zkeulr/aviator/documents/Design_Document/chapters/overview.tex

\clearpage
\section{System Overview}
\subsection{System Block Diagram}
\begin{figure}[h]
    \centering
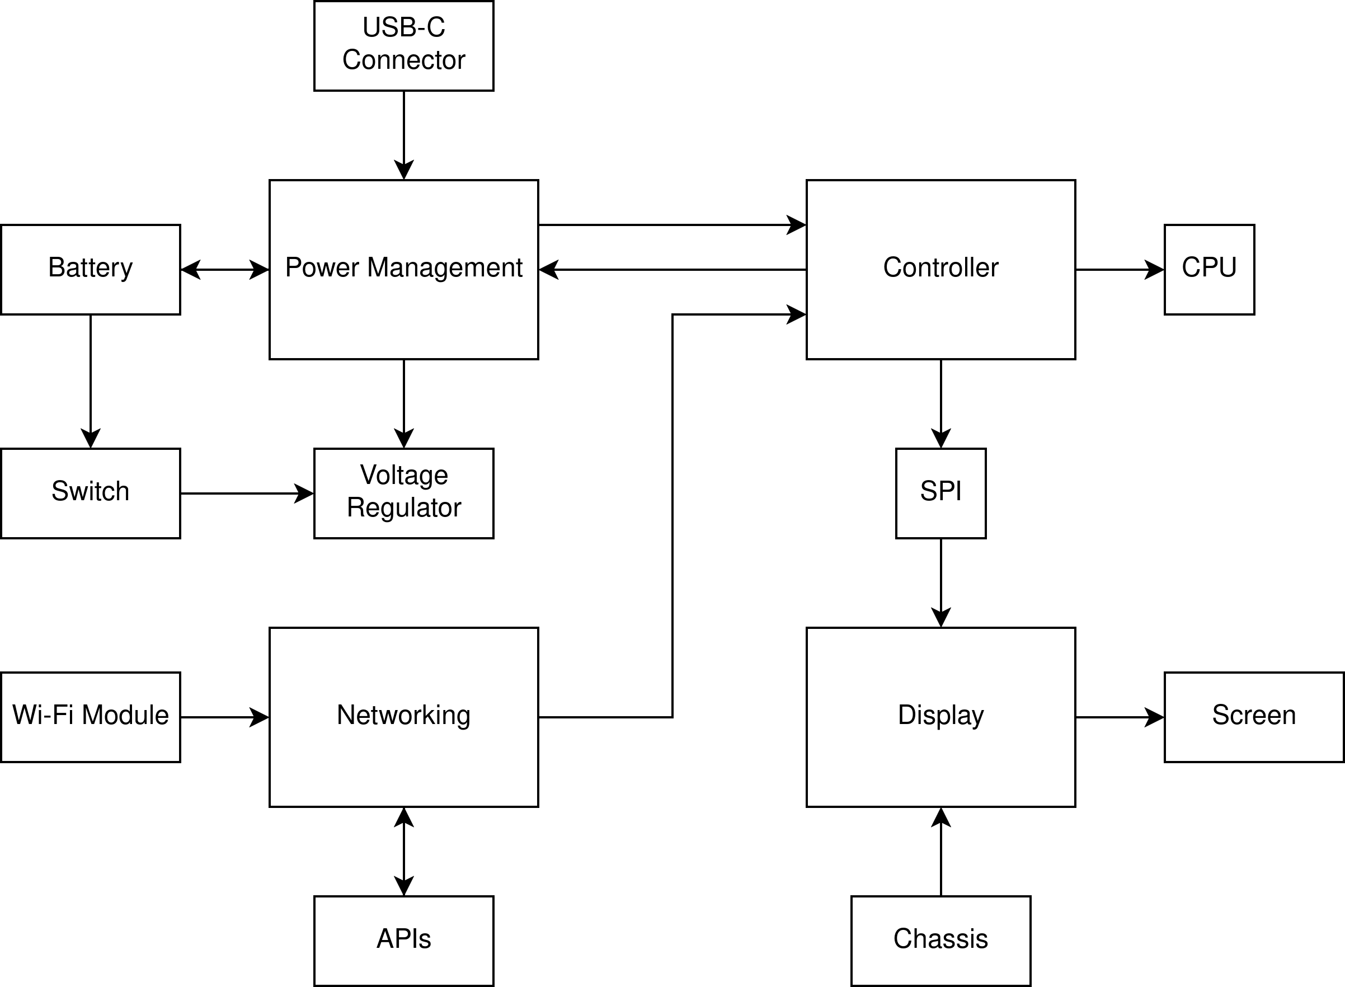
[picture p1: documents/Design_Document_1/images/block_diagram.png]
    
    \caption{Aviator Block Diagram}
\end{figure}

% Activity Diagram
\clearpage
\subsection{System Activity Diagram}
\begin{figure}[h]
    \centering
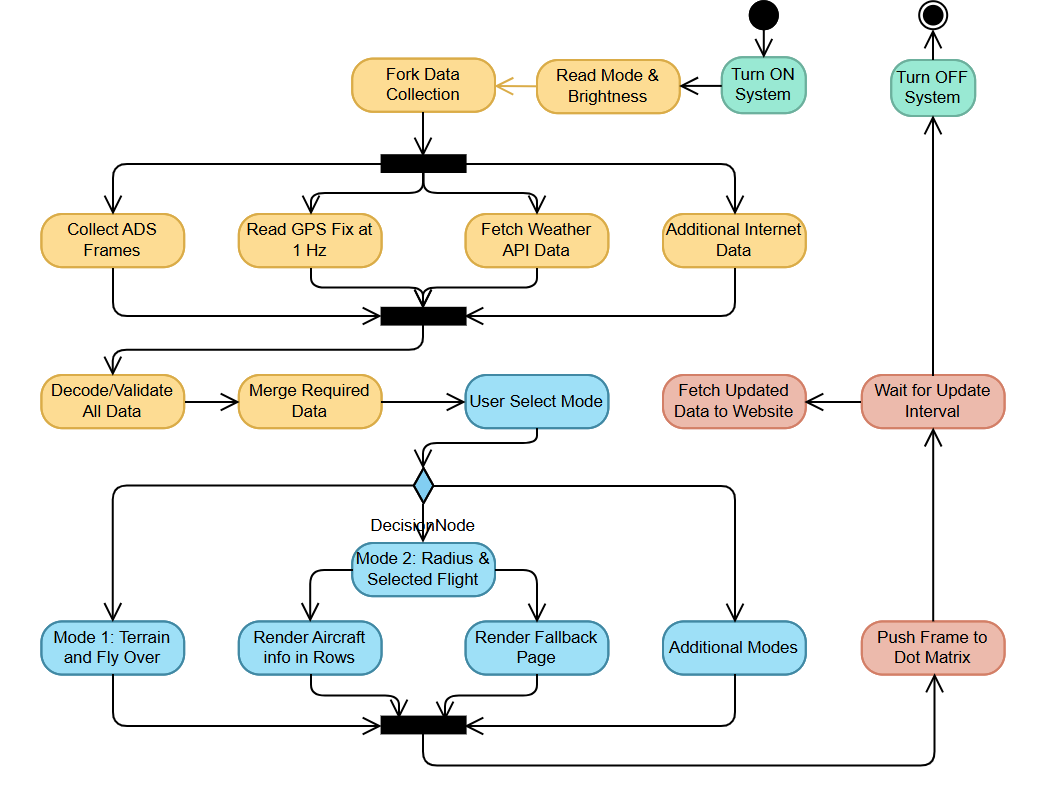
[picture p2: documents/Design_Document_1/images/systemactivitydiagram.png]
     % Change the picture
    \caption{Aviator Activity Diagram}
\end{figure}

% Mechanical Design
\clearpage
\subsection{System Mechanical Design (Extra Credit)}
\begin{figure}[h]
    \centering
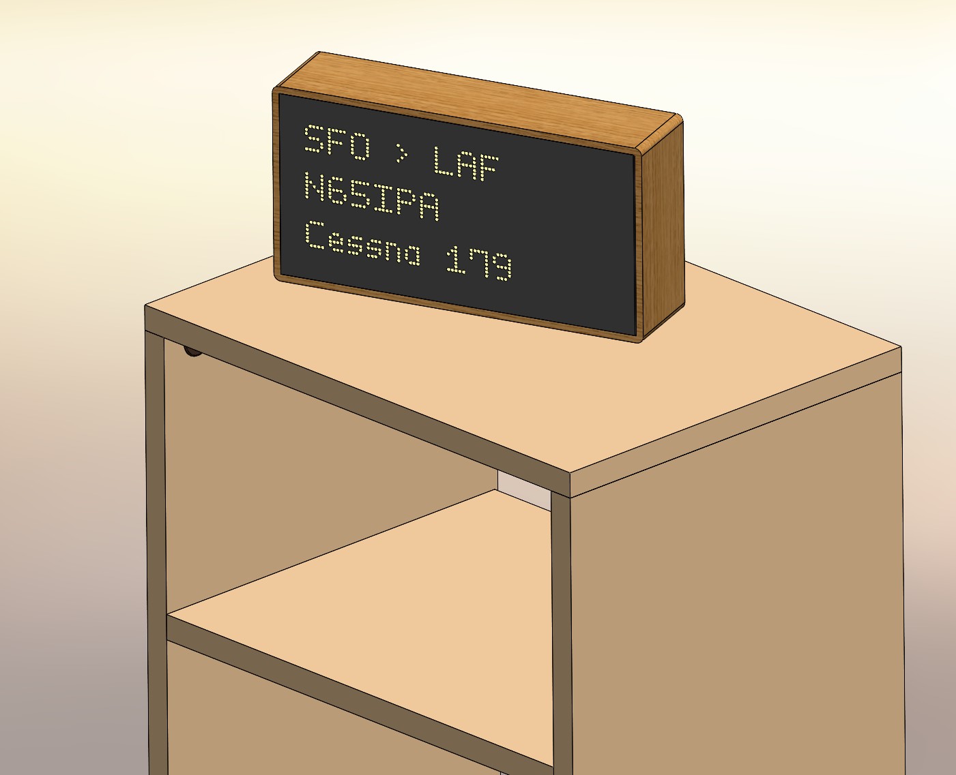
[picture p3: documents/Design_Document/images/CAD/Nightstand Scene.jpg]
     % Change the picture
    \caption{Aviator Enclosure on a generic Nightstand}
\end{figure}

% Integration Approach
\clearpage
\subsection{Integration Approach}
The system integrates an ADS-B software-defined radio (SDR), a cloud data pool,
a local processing subsystem, a display module, and a power management
subsystem. The ADS-B SDR publishes raw flight data to the cloud pool;
the processing subsystem ingests that cloud stream plus external APIs
and user inputs, normalizes and filters the data, and forwards compact
display updates to the display module. The power management subsystem
supplies energy to the processor and display and includes a battery
backup to preserve state and reduce startup latency.

Design priorities are resilience and graceful degradation: if network
connectivity is lost the device continues to show local time and the last
cached flight/weather state; if power to the device is interrupted the
ADS-B transmitter can still upload to the cloud independently. Data is
cached locally and keyed by timestamp so that, on reconnection, the
processor can quickly reconcile and display missed updates. Interfaces
are defined around simple, versioned JSON payloads and REST/WebSocket
endpoints to minimize coupling and simplify testing. Latency, cache
expiration, and failure modes are documented per interface to guide
integration testing.

% System Photograph
\clearpage
\subsection{System Photographs} % Have as many photoes as you need
\begin{figure}[h]
    \centering
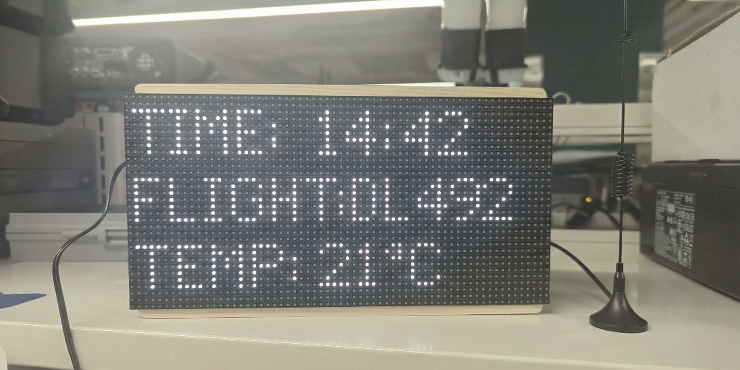
[picture p4: documents/Design_Document/images/ExamplePhoto.jpg]
     % Change the picture
    \caption{Photograph of assembled system}
\end{figure}
\begin{figure}[h]
    \centering
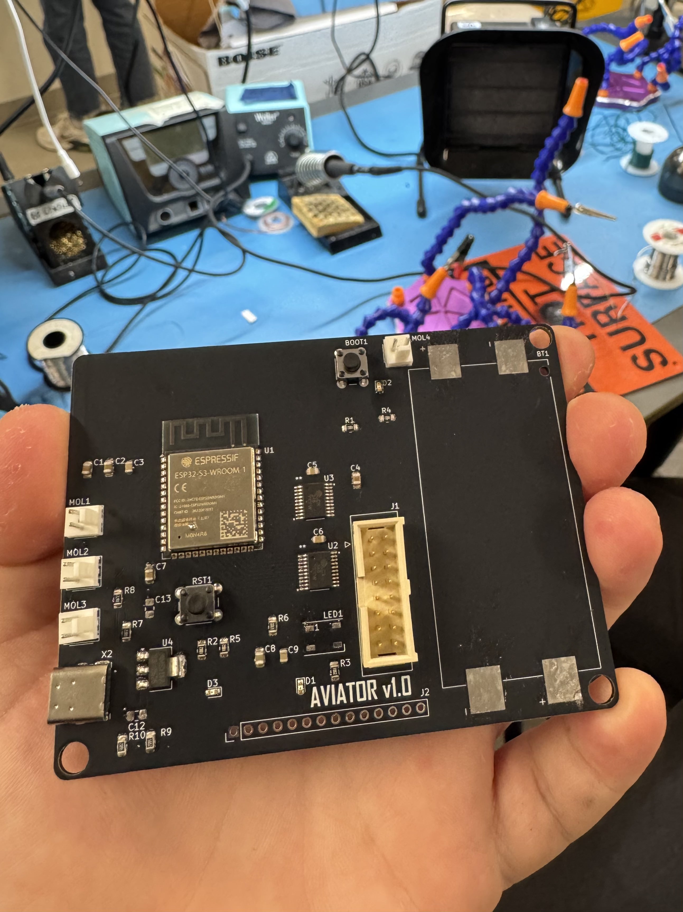
[picture p5: documents/Design_Document/images/PCB/AssembledPCB.jpg]
     % Change the picture
    \caption{Photograph of assembled PCB}
\end{figure}
