zkeulr/aviator/documents/Design_Document/chapters/pcb.tex

\clearpage
\section{PCB Design}
\subsection{PCB Schematics}
\begin{figure}[!h]
    \centering
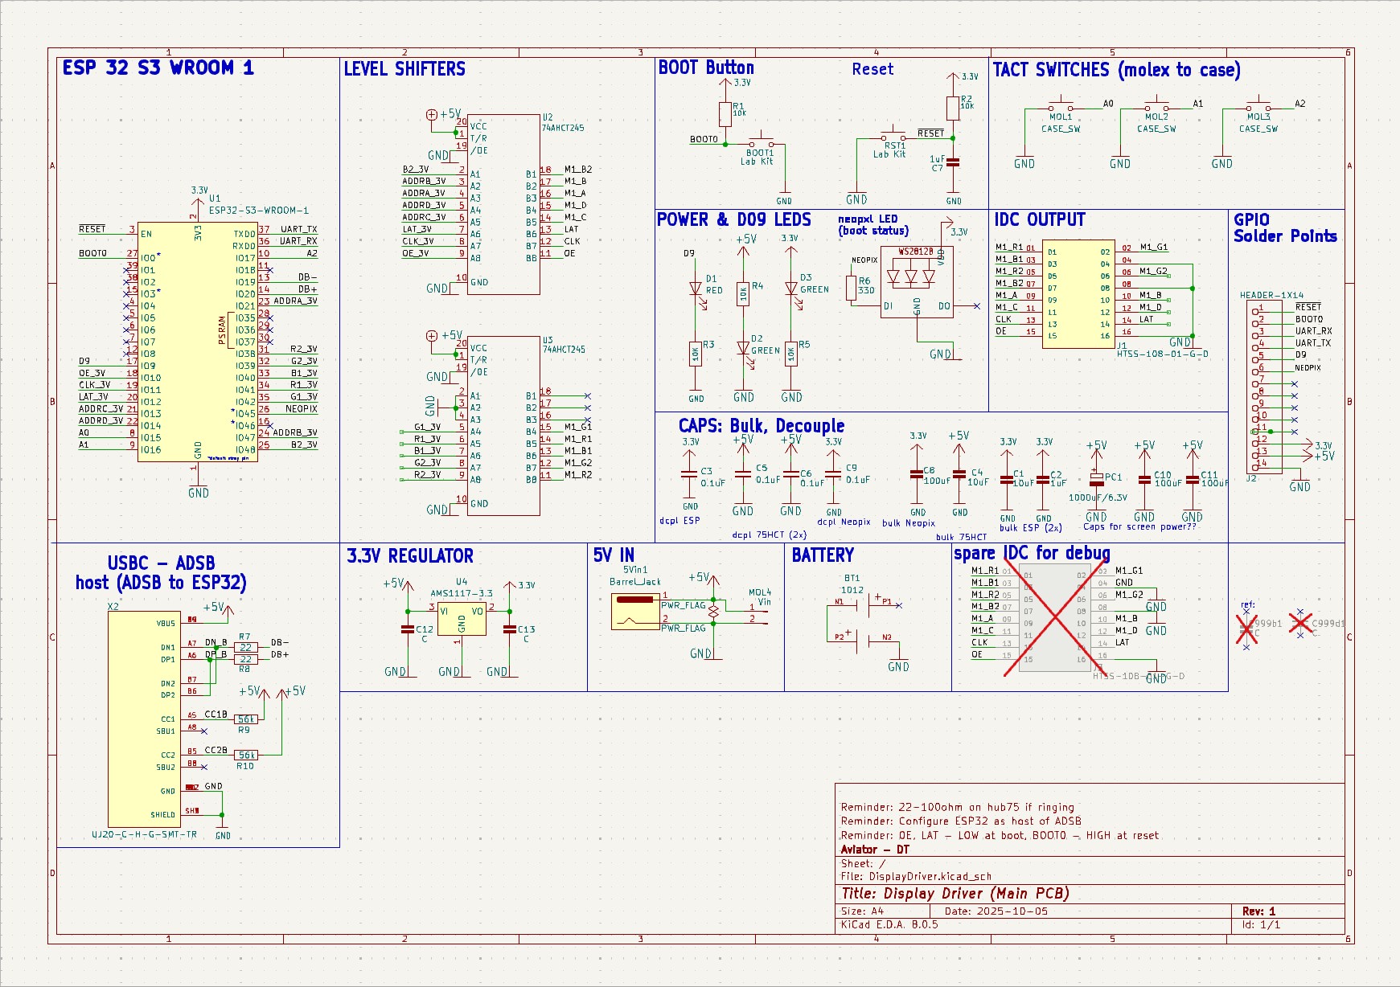
[picture p6: documents/Design_Document/images/PCB/PCB_Schematic.jpg]
     % Change the picture
    \caption{PCB Schematic}
\end{figure}

\clearpage
\subsection{PCB Layout}
\begin{figure}[h]
    \centering
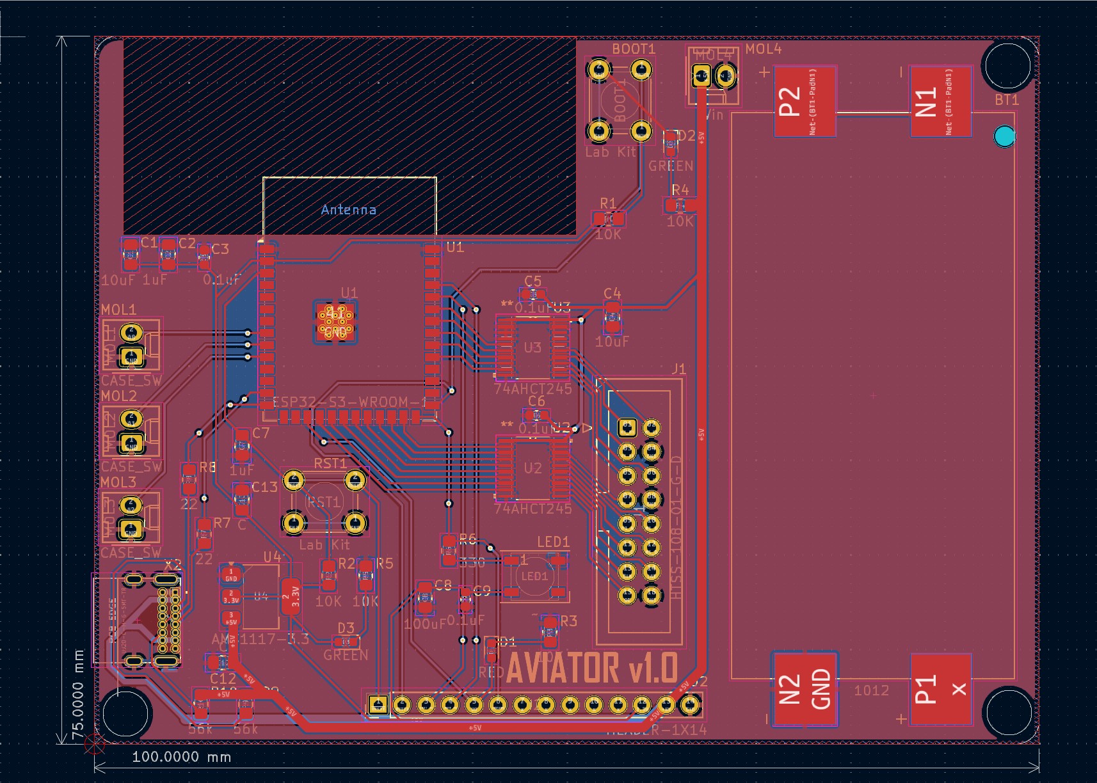
[picture p7: documents/Design_Document/images/PCB/PCB_WithCuPlanes.jpg]
     % Change the picture
    \caption{PCB Layout}
\end{figure}
\begin{figure}[h]
    \centering
     % Change the picture
    \caption{PCB CAD Layout}
\end{figure}
