zkeulr/aviator/documents/Design_Document/chapters/subsystems/display.tex

\subsection{Subsystem 3: Text Display}
% Subsystem Diagram
\subsubsection{Subsystem Diagrams}
\begin{figure}[h]
    \centering
     % Change the picture
    \caption{Display subsystem Block Diagram}
\end{figure} % If your subsystem is more coding, change it to activity diagram

% Specifications
\subsubsection{Specifications}
\begin{enumerate}
    \item Feature a 2048-pixel Dot Display (64 x 32px)
    \item Physical dimensions of housing within 5\% of 64 x 128 x 256 mm.
    \item No noticable screen tear (refresh rate > 60Hz)
\end{enumerate}

% Subsystem Interactions
\subsubsection{Subsystem Interactions}
The display subsystem links the main PCB and the LED Matrix. This subsystem will interface all subsystems on and the main PCB. It will recieve data from the network and communiations subsystem, from the main PCB and processing subsytem it will recieve commands regarding the format of the display, interpret the commands, and display the relevant air traffic data.

% Core ECE
\subsubsection{Core ECE Design Tasks}
\begin{itemize}
    \item \textbf{ECE 27000}: Provides a solid foundation in logic circuits. Helps for designing registers, data paths, logic that drives the LED panel.
    \item \textbf{ECE 25500}: Provides a base understanding of transisters, amplifiers, and fundamentals into I-V behavior.
    \item \textbf{ECE 40862}: Teaches valuable STM concepts such as programming, interrupts, and DMA which are needed to drive the display controller efficiently.
\end{itemize}

% Schematics
\subsubsection{Schematics}

\begin{figure}[H]
    \centering
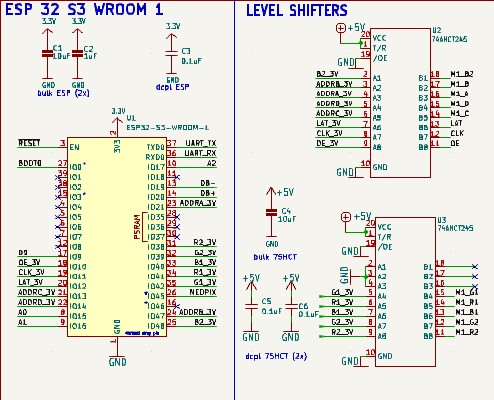
[picture p16: documents/Design_Document/images/DisplayDriver/dispDriverSchematic.jpg]
    
    \caption{Display Driver Schematic (1/2)}
\end{figure}

\begin{figure}[H]
    \centering
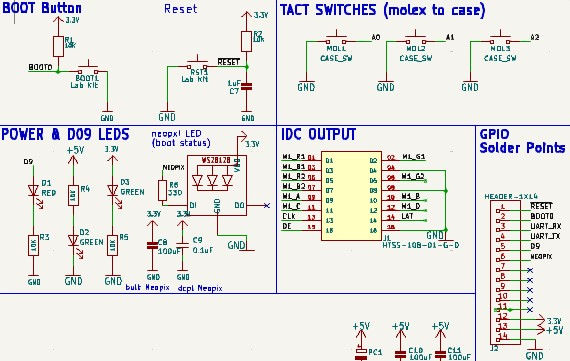
[picture p17: documents/Design_Document/images/DisplayDriver/dispDriverSchematic2.jpg]
    
    \caption{Display Driver Schematic (2/2) and features}
\end{figure}

\FloatBarrier

% Parts List
\subsubsection{Parts}
\begin{itemize}
    \item LED Matrix (ADAFruit, 32x64, P4)
    \begin{itemize}
        \item 02x08 Pin header (IDC Connection)
    \end{itemize}
    \item Resistors:
    \begin{itemize}
        \item 330
        \item 10k (5)
    \end{itemize}
    \item Capacitors
    \begin{itemize}
        \item 0.1uF (0603) (3)
        \item 1uF (0805)
        \item 10uF (0805)
        \item 100uF (0805)
    \end{itemize}
    \item Diodes 
    \begin{itemize}
        \item Red (0603) 
        \item Green (0603) (2)
    \end{itemize}
    \item Switches and Buttons
    \begin{itemize}
        \item 01x02 Molex (Case Switch) (3)
        \item 6mm THM Push Button (2)
    \end{itemize}
\end{itemize}

% Algorithm
\subsubsection{Algorithm}

\begin{lstlisting}
    Initialize:
    Configure GPIOs (DATA, CLK, LAT, OE, row select lines (A,B,C,D))
    Initialize interface for incoming data
    Initialize timer for refresh interrupts
    Set PWM resolution (e.g., 8-bit)

    Main Loop:
    while (true):
        if new frame data available from main PCB:
            copy frame buffer into local memory (double buffer optional)
        
        for each row_index in 0 .. NUM_ROWS-1:
            select_row(row_index)        
            OE = HIGH                   
            
            for pwm_bit = 7 downto 0:    // for 8-bit PWM
                for col_index = 0 .. NUM_COLS-1:
                    pixel = frame_buffer[row_index][col_index]
                    if pixel.red  & (1 << pwm_bit) != 0:
                        DATA_R = HIGH
                    else:
                        DATA_R = LOW
                    if pixel.green & (1 << pwm_bit) != 0:
                        DATA_G = HIGH
                    else:
                        DATA_G = LOW
                    if pixel.blue & (1 << pwm_bit) != 0:
                        DATA_B = HIGH
                    else:
                        DATA_B = LOW
                    
                    pulse(CLK)           
                    
                pulse(LAT)                
                OE = LOW                   
                delay(PWM_DELAY[pwm_bit])  
                
        repeat indefinitely
\end{lstlisting}

% Theory of Operation
\subsubsection{Theory of Operation}
\paragraph{}
The Display subsystem serves as the primary interface between the ESP32-S3-WROOM-1 microcontroller and a HUB75d 32×64 RGB LED matrix, enabling real-time visualization of aviation and weather data. 
The ESP32 handles pixel generation, frame buffering, and timing control for row and column scanning of the display. 
Core signals — including LAT (latch), OE (output enable), CLK (clock), and address lines A–E — are driven directly from the ESP32’s GPIO pins and level-shifted from 3.3 V logic to the 5 V domain required by the HUB75 interface. 
The RGB data lines (R1, G1, B1, R2, G2, B2) are similarly translated to ensure proper color channel switching for both the upper and lower halves of the LED matrix. 
\paragraph{}
During operation, the ESP32 continuously cycles through the address lines, updating one row at a time while controlling brightness through pulse-width modulation synchronized with the OE signal. 
Power is supplied through regulated 5 V and 3.3 V rails, supporting both the LED panel and logic circuitry. 
Optional pushbuttons provide manual reset and boot functionality, while status LEDs indicate system power and data activity. 
In system deployment, the display subsystem retrieves aircraft position and weather telemetry from networked sources and ADS-B data, translating this incoming data into text output or images. 
This modular design allows the subsystem to function independently or as an integrated component of the larger Aviator platform, focusing on robustness, timing precision, and electrical isolation between logic and display domains.

% Specification Measurement
\subsubsection{Specifications Measurement}
\begin{enumerate}
    \item Feature a 2048-pixel Dot Display (64 x 32px)
    \item   The correct screen was ordered, featuring a 32x64px RGB LED matrix
    \item Physical dimensions of housing within 5\% of 64 x 128 x 256 mm.
    \item   Measured with ruler and calipers, the actual screen dimensions are 127 x 255 mm.
    \item No noticable screen tear (refresh rate > 60Hz)
    \item   In observing the screen during normal operation, the image is clear and constant with no noticable tear. Achieved >60Hz refresh rate
          
\end{enumerate}

% Standards
\subsubsection{Standards}
\begin{itemize}
    \item \textbf{IEC 61010}: Safety for low-voltage electronic equipment; ensures protection against shorts, overcurrent, and handling risks.
    \item \textbf{SPI/I²C}: If MCU/controller communicates with peripheral ICs over standard buses.
    \item \textbf{HUB75}: Standard for 32×64 RGB LED matrices; timing, row multiplexing, and data latching must be followed.
    \item \textbf{JESD51}: Important for high-current LED arrays; ensures heat dissipation and junction temperatures are within safe limits.
\end{itemize}
