zkeulr/aviator/aviator/emoji/README.txt

╔═════════════════════════════════════════════════════════════════════════════╗
║                    ~~~ SerenityOS RGI emoji set ~~~                         ║
╟─────────────────────────────────────────────────────────────────────────────╢
║                                                                             ║
║ → This archive was created: 2025-12-07 23:59:01                             
║                                                                             ║
║ → Downloaded from: https://emoji.serenityos.net/                            
║                                                                             ║
║ → Source: https://github.com/SerenityOS/serenity/tree/master/Base/res/emoji 
║                                                                             ║
║ → Only Unicode RGI(recommended for general interchange) emoji               
║   included in this set                                                      
║                                                                             ║
║ → License: BSD 2-Clause License                                             
║                                                                             ║
║ ⌂ LICENSE.txt - Complete license for these emoji                            
║                                                                             ║
║ ⌂ LIST_OF_EMOJI.txt - All emoji, glyphs and names included in this set      
║                                                                             ║
╚═════════════════════════════════════════════════════════════════════════════╝
