zkeulr/aviator/documents/Design_Document/Design_Document.tex

\documentclass[letterpaper, 11pt]{article}
\usepackage{cite,enumitem,listings, comment}
\usepackage[export]{adjustbox}
\usepackage{amsmath,amssymb,amsfonts}
\usepackage{algorithmic}
\usepackage{graphicx}
\usepackage{textcomp}
\usepackage{graphicx}
\usepackage{geometry}
\usepackage{tabularx}
\usepackage{xcolor}
\usepackage{soul}
\usepackage{chngcntr}
\usepackage{url}
\usepackage{hyperref}
\usepackage{graphicx}
\usepackage{float}
\usepackage{placeins}
\usepackage{caption}
\usepackage{graphicx}
\counterwithin{figure}{subsection}

\begin{document}

%%%%%%%%%%%%%%%% Document Starts %%%%%%%%%%%%%%%%%%%%%

% Title page 
\title{Aviator Design Document}
\author{David Thoe, Joshua Kim, Zeke Ulrich, Juan Vargas}
\date{\today}
\maketitle

\begin{center}
    GTA: Ruihang Ni \\
    Professor: Minghao Qi
\end{center}

% Sketch goes here
\begin{figure}[h]
    \centering
    
    \caption{Sketch}
\end{figure}

\clearpage
\tableofcontents

\clearpage
\listoffigures

\clearpage
\listoftables

% Revision Log Page
\clearpage
\section{Revision Log}
% For every update, copy a whole LATEX code line and adjust 
% accordingly. In theory, update every time you make major 
% changes in the document. The \& symbol serves to separate 
% items in the table. If you are new to this, align the \& 
% so that it looks more like a table in the code. 
\begin{table}[h]
    \centering
    \begin{tabularx}{\textwidth}{|l|c|X|c|}
        \hline
        Date       & Revision & Changes              & Initials \\ \hline
        05/03/2024 & v0.1     & Initial Release      & ZU       \\ \hline
        09/18/2025 & v0.2     & First Submission     & ZU       \\ \hline
        10/05/2025 & v0.3     & Second Submission    & DT       \\ \hline
        11/11/2025 & v0.4     & Corrections, Updates & DT       \\ \hline
        12/13/2025 & v1.0     & Final Release        & ZU       \\ \hline
    \end{tabularx}
    \caption{Revision Log}
\end{table}

% Glossary Page
\clearpage
\section{Glossary} % Document key words and acronyms here. 
\begin{itemize}
    \item \textbf{API} Application Programming Interface.
    \item \textbf{ADS-B} Automatic Dependent Surveillance-Broadcast
\end{itemize}

\include{chapters/intro}
\include{chapters/requirements}
\include{chapters/overview}
\section{Subsystems}
\include{chapters/subsystems/processing}
\include{chapters/subsystems/power}
\include{chapters/subsystems/display}
\include{chapters/subsystems/network}
\include{chapters/pcb}
\include{chapters/status}
\include{chapters/team_structure}

\end{document}
