zkeulr/aviator/documents/Design_Document/Design_Document_1.tex

\documentclass[letterpaper, 11pt]{article}
\usepackage{cite,enumitem,listings, comment}
\usepackage[export]{adjustbox}
\usepackage{amsmath,amssymb,amsfonts}
\usepackage{algorithmic}
\usepackage{graphicx}
\usepackage{textcomp}
\usepackage{graphicx}
\usepackage{geometry}
\usepackage{tabularx}
\usepackage{xcolor}
\usepackage{soul}
\usepackage{chngcntr}
\usepackage{url}
\usepackage{hyperref}
\counterwithin{figure}{subsection}

\begin{document}

%%%%%%%%%%%%%%%% Document Starts %%%%%%%%%%%%%%%%%%%%%

% Title page 
\title{Aviator Design Document}
\author{David Thoe, Joshua Kim, Zeke Ulrich, Juan Vargas}
\date{\today}
\maketitle

\begin{center}
    GTA: Zixiao Ma \\
    Professor: Ryan Beasley
\end{center}

% Sketch goes here
\begin{figure}[h]
    \centering
    
    \caption{[Caption]}
\end{figure}

\clearpage
\tableofcontents

\clearpage
\listoffigures

\clearpage
\listoftables

% Revision Log Page
\clearpage
\section*{Revision Log}
% For every update, copy a whole LATEX code line and adjust 
% accordingly. In theory, update every time you make major 
% changes in the document. The \& symbol serves to separate 
% items in the table. If you are new to this, align the \& 
% so that it looks more like a table in the code. 
\begin{table}[h]
    \begin{tabularx}{\textwidth}{|l|c|X|} % 
        \hline
        Date      & Revision & Changes         \\ \hline
        5/3/2024  & v0.1     & Initial Release \\ \hline
        9/18/2025 & v1.0     & First Draft     \\ \hline
    \end{tabularx}
    \caption{Revision Log}
\end{table}

% Glossary Page
\clearpage
\section*{Glossary} % Document key words and acronyms here. 
\begin{itemize}
    \item \textbf{API} Application Programming Interface.
\end{itemize}

\include{chapters/intro}
\include{chapters/requirements}
\include{chapters/overview}
\section{Subsystems}
\include{chapters/subsystems/processing}
\include{chapters/subsystems/power}
\include{chapters/subsystems/display}
\include{chapters/subsystems/network}
\include{chapters/pcb}
\include{chapters/status}
\include{chapters/team_structure}

%%%%%%%%%%%%%%%%% Biblography %%%%%%%%%%%%%%%%%%%%%%%
\clearpage
\section{Bibliography}

 [Here are some examples. IEEE format can be found on \href{https://owl.purdue.edu/owl/research_and_citation/ieee_style/ieee_overview.html}{\hl{Purdue OWL}}. ]

\begin{thebibliography}{}

    \bibitem{b1}
    “Data Platform - Open Power System data,” Apr. 15, 2020. https://data.open-power-system-data.org/household\_data/

    \bibitem{b2}
    Author,"Title," \emph{Journal},volume,number, page range, month year, DOI.

    \bibitem{b3}
    Author. "Page."Website. URL(accessed month day,year)

\end{thebibliography}

%%%%%%%%%%%%%%%%% Appendix %%%%%%%%%%%%%%%%%%%%%%%%%
\clearpage
\section{Appendices}
 [This section is mainly designed for code. You can directly generate a somewhat decent display of your code file or psuedo code by using the template provided below. You can have as many appendix as you want. In the document, you can refer to the code posted here instead of pasting the whole code in the body. ]

\end{document}
