zkeulr/aviator/documents/Design_Document/images/DisplayDriver/DisplayDriver Schematic.jpg

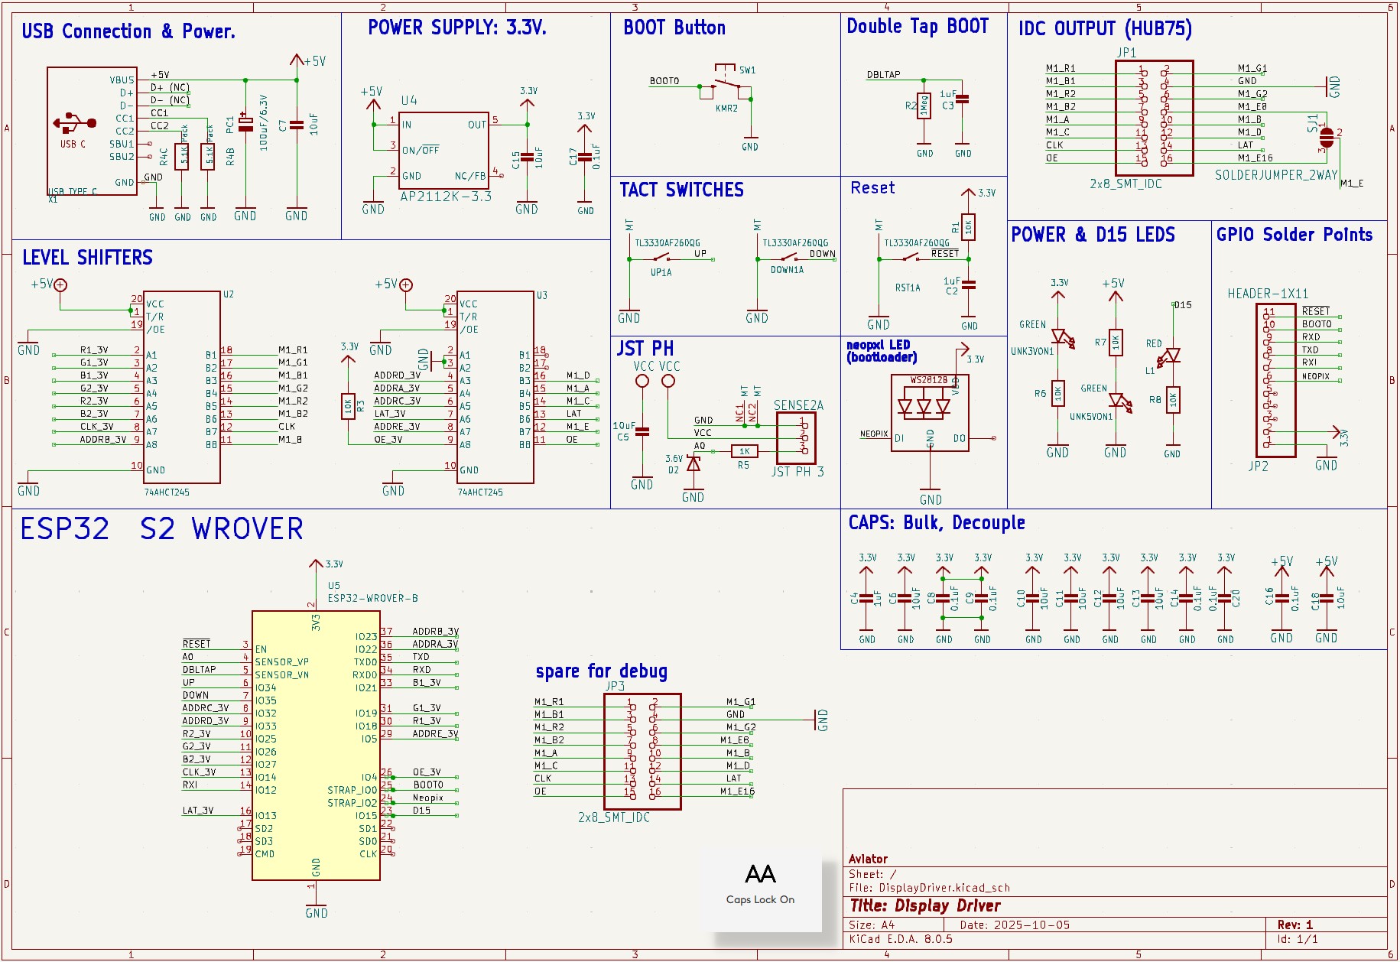
documents/Design_Document/images/DisplayDriver/DisplayDriver Schematic.jpg
