zkeulr/aviator/documents/Design_Document/images/DisplayDriver/DriverBoardFeatures.jpg

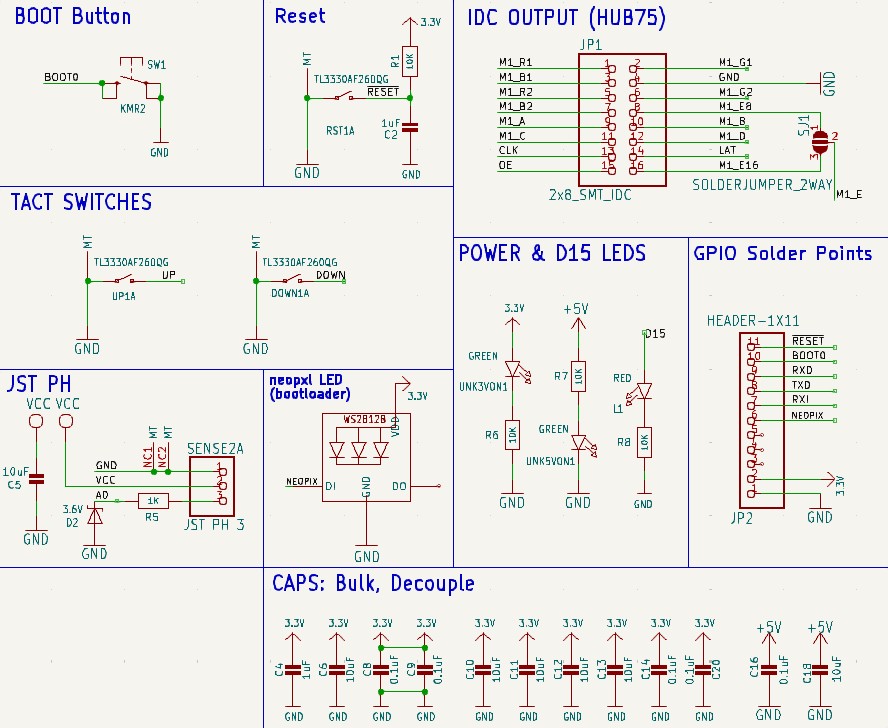
documents/Design_Document/images/DisplayDriver/DriverBoardFeatures.jpg
