zkeulr/aviator/documents/Design_Document/images/DisplayDriver/USBPwrGeneric.jpg

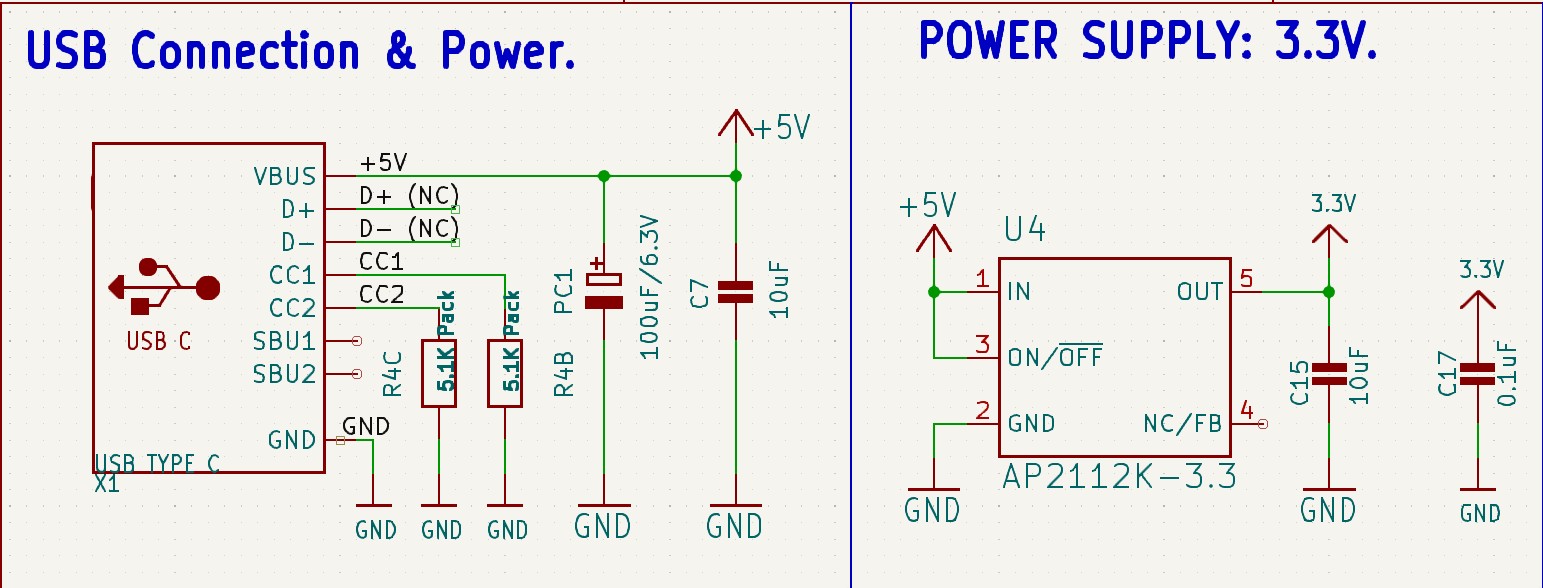
documents/Design_Document/images/DisplayDriver/USBPwrGeneric.jpg
