zkeulr/aviator/documents/Design_Document/images/juan.jpg

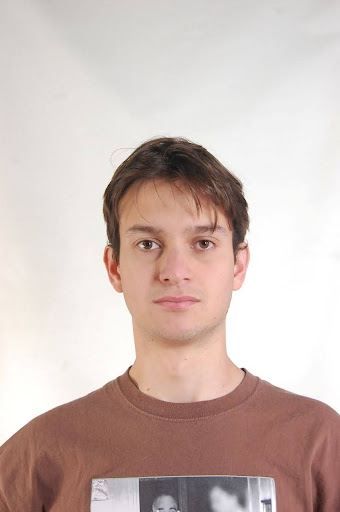
documents/Design_Document/images/juan.jpg
