zkeulr/aviator/documents/Design_Document/images/tempSF.jpg

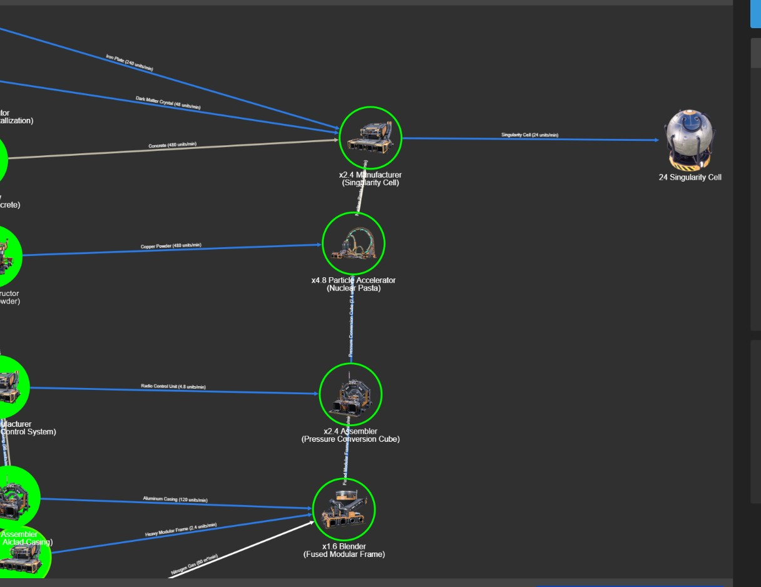
documents/Design_Document/images/tempSF.jpg
