zkeulr/aviator/DisplayDriver/PCBMaterials.csv

Reference | Value | Datasheet | Footprint | Qty | DNP
5Vin1 | Barrel_Jack | ~ |  | 1 | x
BOOT1,RST1 | Lab Kit | ~ | Button_Switch_THT:SW_PUSH_6mm | 2 | x |  | !
BT1 | 1012 |  | DisplayLibrary:BAT_1012 | 1 | x |  | !
C1,C4 | 10uF |  | Capacitor_SMD:C_0805_2012Metric_Pad1.18x1.45mm_HandSolder | 2 | x | ECE SHOP
C2,C7 | 1uF |  | Capacitor_SMD:C_0805_2012Metric_Pad1.18x1.45mm_HandSolder | 2 | x | ECE SHOP
C3,C5,C6,C9 | 0.1uF | ~ | Capacitor_SMD:C_0603_1608Metric | 4 | x | ECE SHOP
C8,C10,C11 | 100uF |  | Capacitor_SMD:C_0805_2012Metric_Pad1.18x1.45mm_HandSolder | 3 | x | ECE SHOP
C12,C12B1,C13,C13B1 | C | -- mixed values -- | -- mixed values -- | 4 | x | TBD
D1 | RED | ~ | LED_SMD:LED_0603_1608Metric | 1 | x | ECE SHOP
D2,D3 | GREEN | ~ | LED_SMD:LED_0603_1608Metric | 2 | x | ECE SHOP
J1 | HTSS-108-01-G-D |  | DisplayDriver:IDC-Header_2x08_P2.54mm_Vertical | 1 | x
J2 | HEADER-1X14 | ~ | Connector_PinHeader_2.54mm:PinHeader_1x14_P2.54mm_Vertical | 1
LED1 | ~ | ~ | LED_SMD:LED_WS2812B_PLCC4_5.0x5.0mm_P3.2mm | 1
MOL1,MOL2,MOL3 | CASE_SW | ~ | Connector_Molex:Molex_KK-254_AE-6410-02A_1x02_P2.54mm_Vertical | 3
MOL4 | Vin | ~ | Connector_Molex:Molex_KK-254_AE-6410-02A_1x02_P2.54mm_Vertical | 1
PC1 | 1000uF/6.3V |  | Capacitor_SMD:C_0805_2012Metric_Pad1.18x1.45mm_HandSolder | 1 | x | ECE SHOP
R1,R2,R3,R4,R5 | 10K | ~ | Resistor_SMD:R_0805_2012Metric_Pad1.20x1.40mm_HandSolder | 5 | x | ECE SHOP
R6 | 330 | ~ | Resistor_SMD:R_0805_2012Metric_Pad1.20x1.40mm_HandSolder | 1 | x | ECE SHOP
R7,R8 | 22 | ~ | Resistor_SMD:R_0805_2012Metric_Pad1.20x1.40mm_HandSolder | 2 | x | ECE SHOP
R9,R10 | 56k | ~ | Resistor_SMD:R_0805_2012Metric_Pad1.20x1.40mm_HandSolder | 2 | x | ECE SHOP
U1 | ESP32-S3-WROOM-1 | https://www.espressif.com/sites/default/files/documentation/esp32-s3-wroom-1_wroom-1u_datasheet_en.pdf | RF_Module:ESP32-S3-WROOM-1 | 1
U2,U3 | 74AHCT245 | https://www.ti.com/lit/ds/symlink/sn74lvch245a.pdf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 | DisplayDriver:PW20 | 2
U4 | AMS1117-3.3 | http://www.advanced-monolithic.com/pdf/ds1117.pdf | Package_TO_SOT_SMD:SOT-223-3_TabPin2 | 1
U5 | AP2112K-3.3 | https://www.diodes.com/assets/Datasheets/AP2112.pdf | Package_TO_SOT_SMD:SOT-23-5 | 1 | x | EXTRA
X2 | UJ20-C-H-G-SMT-TR | https://www.snapeda.com/parts/UJ20-C-H-G-SMT-TR/Same%20Sky/datasheet/ | DisplayDriver:CUI_UJ20-C-H-G-SMT-TR | 1
