zkeulr/aviator/documents/Design_Document/images/DisplayDriver/WroverUsage.jpg

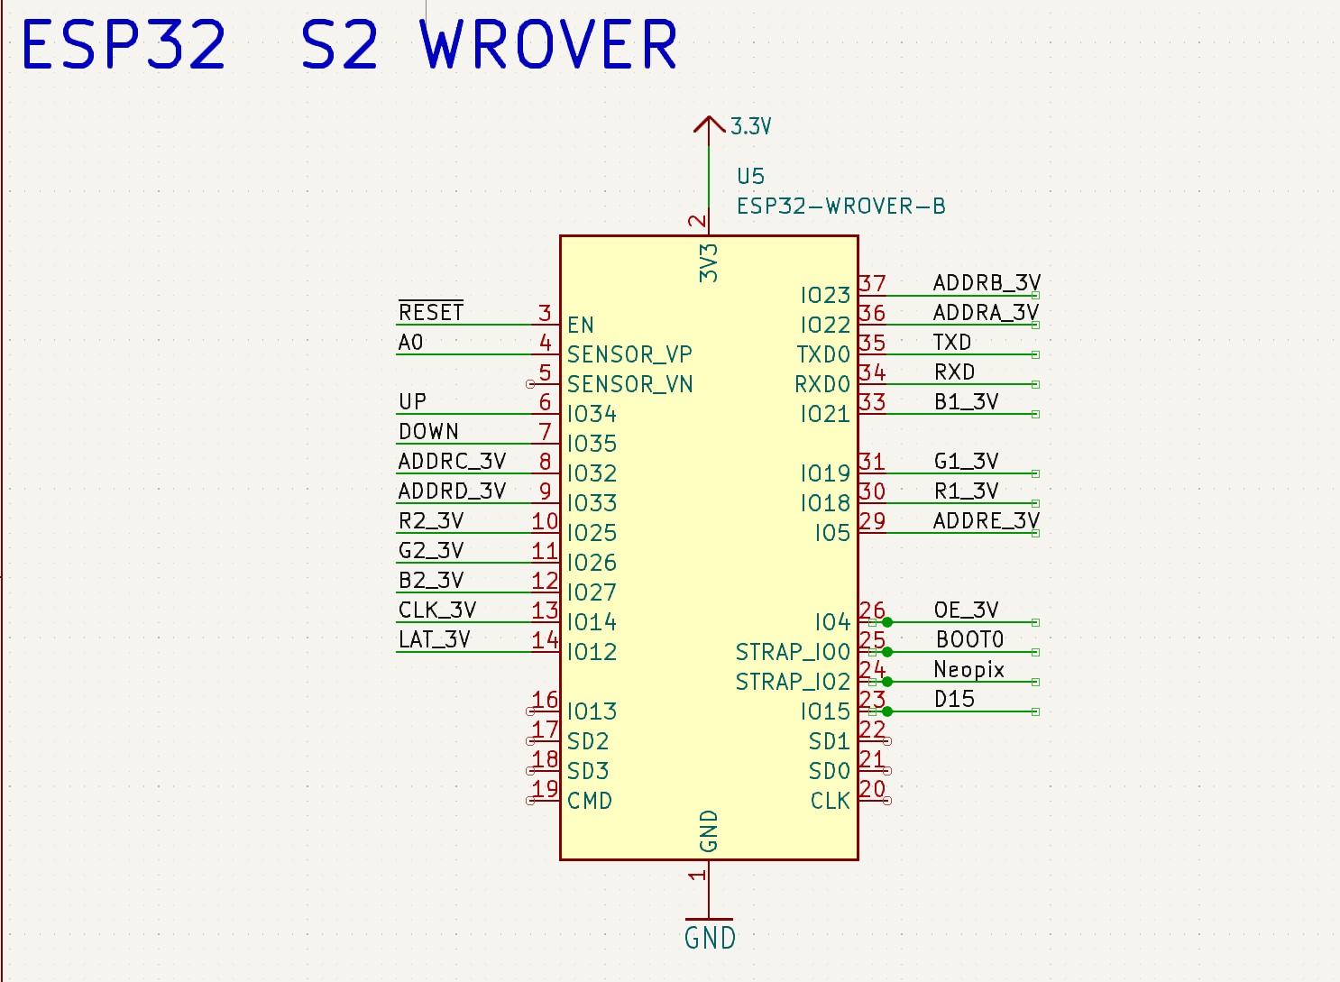
documents/Design_Document/images/DisplayDriver/WroverUsage.jpg
