zkeulr/aviator/DisplayDriver/DisplayDriver.kicad_pcb

## KiCad design DisplayDriver/DisplayDriver.kicad_pcb (2025-10-28)

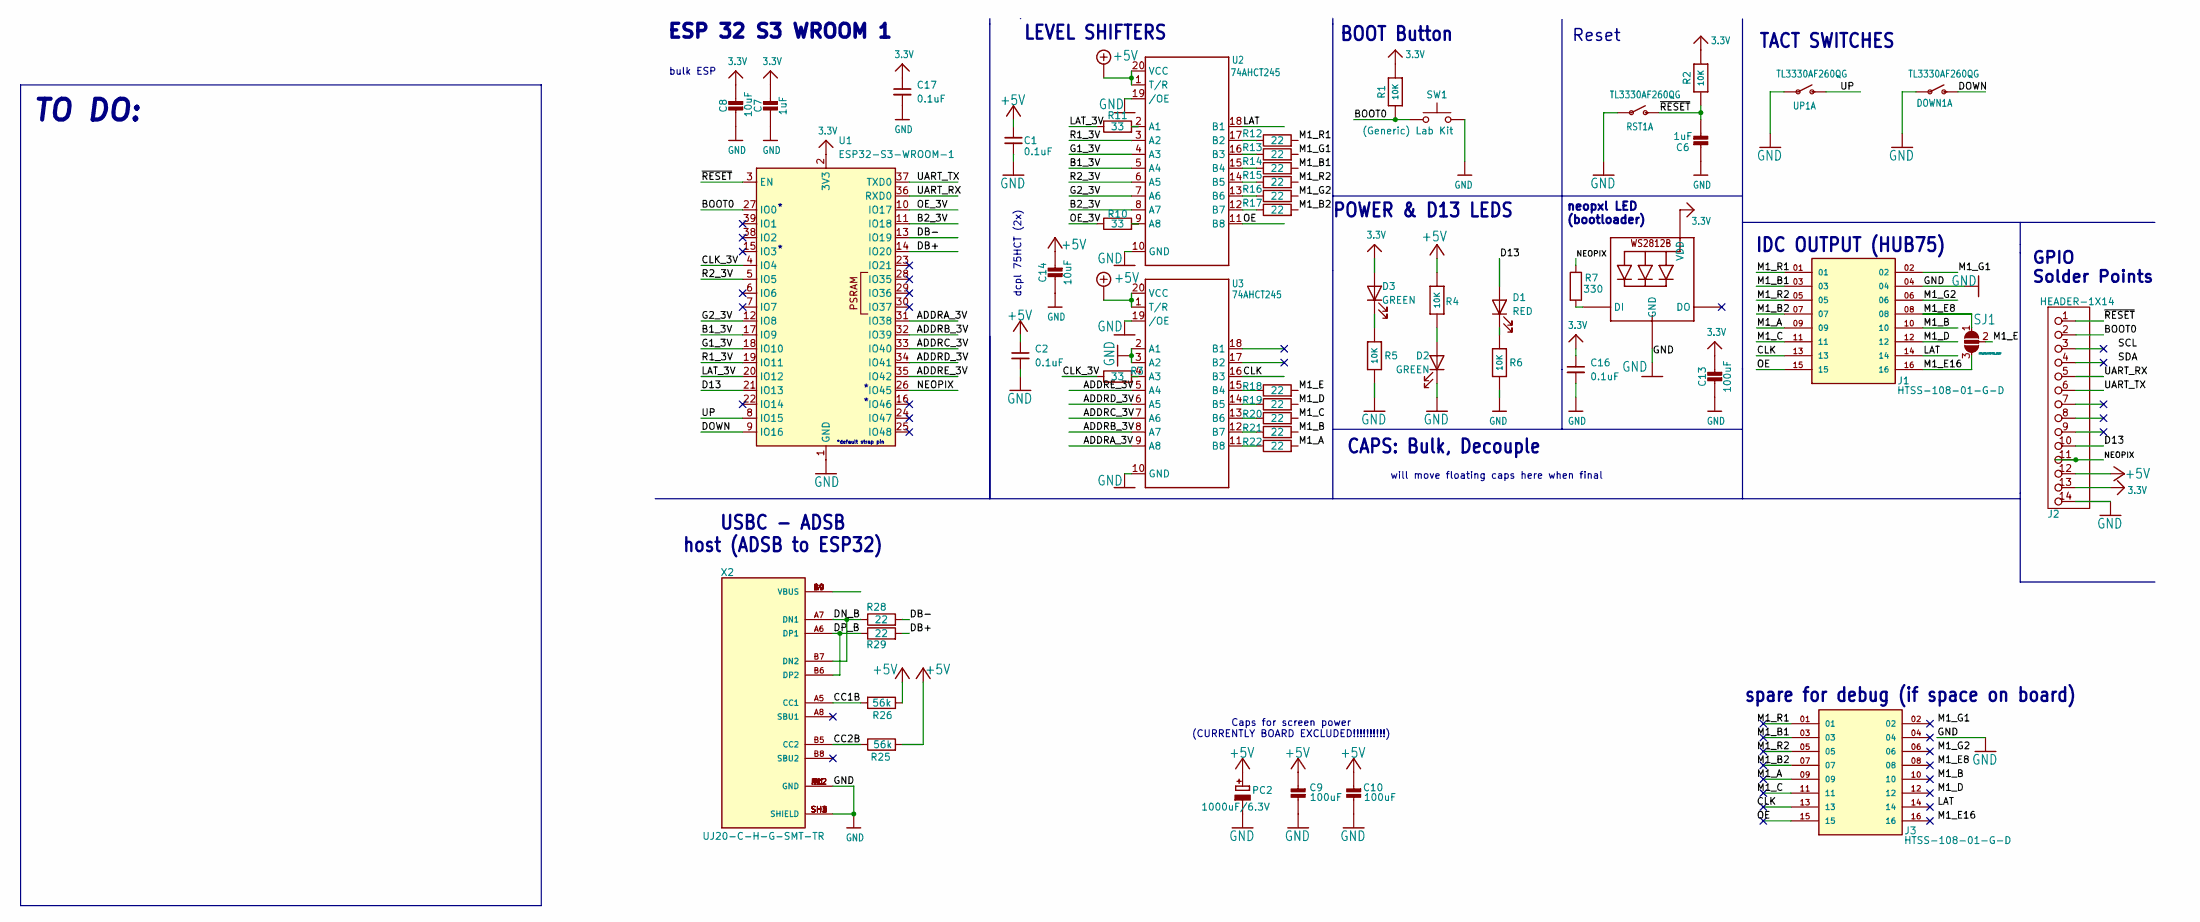
[picture p32: schematic DisplayDriver.kicad_sch, Display Driver]

Parts:
C1, C2, C16, C17: 0.1uF; C_0603_1608Metric
C6, C7: 1uF; C_0805_2012Metric_Pad1.18x1.45mm_HandSolder
C8, C14: 10uF; C_0805_2012Metric_Pad1.18x1.45mm_HandSolder
C9, C10, C13: 100uF; C_0805_2012Metric_Pad1.18x1.45mm_HandSolder
D1: RED; LED_0603_1608Metric
D2, D3: GREEN; LED_0603_1608Metric
DOWN1: TL3330AF260QG; SW_TL3330AF260QG
J1, J3: HTSS-108-01-G-D; IDC-Header_2x08_P2.54mm_Vertical; PARTREV R
J2: HEADER-1X14; PinHeader_1x14_P2.54mm_Vertical
LED1: WS2812B_3535FULL; LED_WS2812B_PLCC4_5.0x5.0mm_P3.2mm
PC2: 1000uF/6.3V; C_0805_2012Metric_Pad1.18x1.45mm_HandSolder
R1, R2, R4, R5, R6: 10K; R_0805_2012Metric_Pad1.20x1.40mm_HandSolder
R3: 33; R_0603_1608Metric
R7: 330; R_0805_2012Metric_Pad1.20x1.40mm_HandSolder
R10, R11: 33; R_0805_2012Metric_Pad1.20x1.40mm_HandSolder
R12, R13, R14, R15, R16, R17, R18, R19, R20, R21, R22: 22; R_0603_1608Metric
R25, R26: 56k; R_0805_2012Metric_Pad1.20x1.40mm_HandSolder
R28, R29: 22; R_0805_2012Metric_Pad1.20x1.40mm_HandSolder
RST1: TL3330AF260QG; SW_TL3330AF260QG
SJ1: SOLDERJUMPER_2WAY; SolderJumper-3_P1.3mm_Open_RoundedPad1.0x1.5mm_NumberLabels
SW1: (Generic) Lab Kit; SW_PUSH_6mm
U1: ESP32-S3-WROOM-1
U2, U3: 74AHCT245; SOIC-20W_7.5x12.8mm_P1.27mm
UP1: TL3330AF260QG; SW_TL3330AF260QG
X2: UJ20-C-H-G-SMT-TR; CUI_UJ20-C-H-G-SMT-TR; PARTREV 1.01

Connections:
3.3V: C7.2, C8.2, C13.2, C16.1, C17.1, D3.2 (A), J2.13, LED1.2 (VDD), R1.2, R2.2, U1.2 (3V3)
+5V: C1.1, C2.1, C9.2, C10.2, C14.2, J2.12, PC2.+, R4.1, R25.2, R26.1, U2.1 (T/R), U2.20 (VCC), U3.1 (T/R), U3.20 (VCC)
/ADDRA_3V: U1.31 (IO38), U3.9 (A8)
/ADDRB_3V: U1.32 (IO39), U3.8 (A7)
/ADDRC_3V: U1.33 (IO40), U3.7 (A6)
/ADDRD_3V: U1.34 (IO41), U3.6 (A5)
/ADDRE_3V: U1.35 (IO42), U3.5 (A4)
/B1_3V: U1.17 (IO9), U2.5 (A4)
/B2_3V: U1.11 (IO18), U2.8 (A7)
/BOOT0: J2.2, R1.1, SW1.1, U1.27 (IO0)
/CC1B: R26.2, X2.A5 (CC1)
/CC2B: R25.1, X2.B5 (CC2)
/CLK: J1.13, U3.16 (B3)
/CLK_3V: R3.1, U1.4 (IO4)
/D13: D1.2 (A), J2.10, U1.21 (IO13)
/DB+: R29.2, U1.14 (IO20)
/DB-: R28.2, U1.13 (IO19)
/DN_B: R28.1, X2.A7 (DN1), X2.B7 (DN2)
/DOWN: DOWN1.2 (S), U1.9 (IO16)
/DP_B: R29.1, X2.A6 (DP1), X2.B6 (DP2)
/G1_3V: U1.18 (IO10), U2.4 (A3)
/G2_3V: U1.12 (IO8), U2.7 (A6)
/LAT: J1.14, U2.18 (B1)
/LAT_3V: R11.1, U1.20 (IO12)
/M1_A: J1.09, R22.2
/M1_B: J1.10, R21.2
/M1_B1: J1.03, R14.2
/M1_B2: J1.07, R17.2
/M1_C: J1.11, R20.2
/M1_D: J1.12, R19.2
/M1_E: R18.2, SJ1.2
/M1_E8: J1.08, SJ1.1
/M1_E16: J1.16, SJ1.3
/M1_G1: J1.02, R13.2
/M1_G2: J1.06, R16.2
/M1_R1: J1.01, R12.2
/M1_R2: J1.05, R15.2
/NEOPIX: J2.11, R7.1, U1.26 (IO45)
/OE: J1.15, U2.11 (B8)
/OE_3V: R10.1, U1.10 (IO17)
/R1_3V: U1.19 (IO11), U2.3 (A2)
/R2_3V: U1.5 (IO5), U2.6 (A5)
/UART_RX: J2.5, U1.36 (RXD0)
/UART_TX: J2.6, U1.37 (TXD0)
/UP: U1.8 (IO15), UP1.2 (S)
/~RESET: C6.1, J2.1, R2.1, RST1.2 (S), U1.3 (EN)
GND: C1.2, C2.2, C6.2, C7.1, C8.1, C9.1, C10.1, C13.1, C14.1, C16.2, C17.2, D2.1 (K), DOWN1.1, J1.04, J2.14, LED1.4 (GND), PC2.-, R5.2, R6.2, RST1.1, SW1.2, U1.1 (GND), U1.40 (GND), U1.41 (GND), U2.10 (GND), U2.19 (/OE), U3.2 (A1), U3.3 (A2), U3.10 (GND), U3.19 (/OE), UP1.1, X2.A1 (GND), X2.A12 (GND), X2.B1 (GND), X2.B12 (GND), X2.SH1 (SHIELD), X2.SH2 (SHIELD), X2.SH3 (SHIELD), X2.SH4 (SHIELD)
unnamed: D1.1 (K), R6.1
unnamed: D2.2 (A), R4.2
unnamed: D3.1 (K), R5.1
unnamed: LED1.1 (DI), R7.2
unnamed: R11.2, U2.2 (A1)
unnamed: R10.2, U2.9 (A8)
unnamed: R12.1, U2.17 (B2)
unnamed: R13.1, U2.16 (B3)
unnamed: R14.1, U2.15 (B4)
unnamed: R15.1, U2.14 (B5)
unnamed: R16.1, U2.13 (B6)
unnamed: R17.1, U2.12 (B7)
unnamed: R3.2, U3.4 (A3)
unnamed: R18.1, U3.15 (B4)
unnamed: R19.1, U3.14 (B5)
unnamed: R20.1, U3.13 (B6)
unnamed: R21.1, U3.12 (B7)
unnamed: R22.1, U3.11 (B8)
unnamed: X2.A4 (VBUS), X2.A9 (VBUS), X2.B4 (VBUS), X2.B9 (VBUS)

Notes on the sheet:
ESP 32 S3 WROOM 1
TO DO:
will move floating caps here when final
bulk ESP
IDC OUTPUT (HUB75)
POWER & D13 LEDS
BOOT Button
CAPS: Bulk, Decouple
dcpl 75HCT (2x)
Caps for screen power (CURRENTLY BOARD EXCLUDED!!!!!!!!!!)
*default strap pin
LEVEL SHIFTERS
spare for debug (if space on board)
GPIO Solder Points
TACT SWITCHES
neopxl LED (bootloader)
USBC - ADSB host (ADSB to ESP32)
Reset

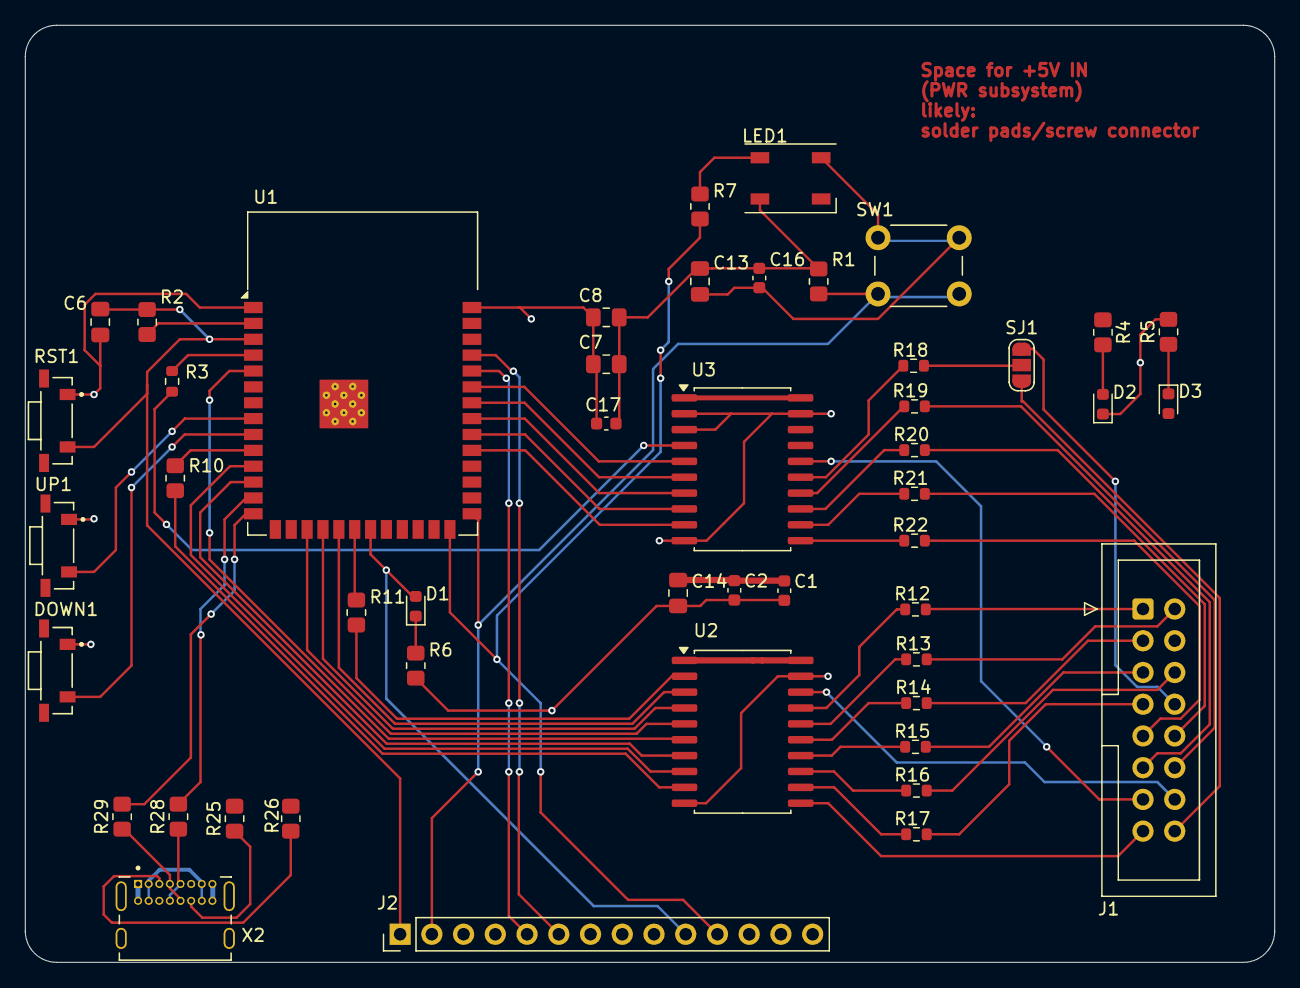
[picture p33: board DisplayDriver.kicad_pcb from above]

Board: 2 copper layers, 100.0 x 75.0 mm, 48 parts (0 on the bottom side), 66 nets.
