zkeulr/aviator/(commit log)

2025-09-23 Added pcb
    [pcb.kicad_pcb, pcb.kicad_sch]
2025-10-02 Disp Driver KiCad Add
    [Adafruit MatrixPortal S3.sch, DisplayDriver.kicad_pcb, DisplayDriver.kicad_sch]
2025-10-04 Halfway Disp. Driver for PC work
    [Adafruit MatrixPortal S3.kicad_pcb, Adafruit MatrixPortal S3.kicad_sch, DisplayDriver.kicad_sch]
2025-10-05 Display Driver Schematic - First Prototype
    [DisplayDriver.kicad_sch]
2025-10-06 Design Doc 2 Final
    [DisplayDriver.kicad_pcb]
2025-10-07 PCB commit pls
    [DisplayDriver.kicad_pcb, DisplayDriver.kicad_sch]
2025-10-09 PC work
    [DisplayDriver.kicad_sch]
2025-10-09 desktop to laptop
    [Adafruit MatrixPortal S3.kicad_sch, DisplayDriver.kicad_pcb, DisplayDriver.kicad_sch]
2025-10-09 dd from backup
    [DisplayDriver.kicad_sch]
2025-10-09 eod lab thurs
    [DisplayDriver.kicad_pcb, DisplayDriver.kicad_sch]
2025-10-10 halfway commit PCB
    [DisplayDriver.kicad_pcb, DisplayDriver.kicad_sch]
2025-10-11 PCB wiring
    [DisplayDriver.kicad_pcb, DisplayDriver.kicad_sch]
2025-10-13 packaging review submission +gerbers
    [Adafruit MatrixPortal S3.kicad_sch, Adafruit MatrixPortal S3.sch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]
2025-10-15 PD Chip addition, proper schematic for Breadboarding today
    [DisplayDriver.kicad_pcb]
2025-10-15 disp. driver .py
2025-10-24 Major PCB Revisions.
    [DisplayDriver.kicad_pcb, DisplayDriver.kicad_sch]
2025-10-28 aaa
    aa
    [Adafruit MatrixPortal S3.sch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]
2025-10-29 bat footprint
    [DisplayDriver.kicad_pcb, DisplayDriver.kicad_sch]
2025-10-30 PCB skjdcnsjk
    [DisplayDriver-B_Cu.gbr, DisplayDriver-B_Mask.gbr, DisplayDriver-B_Silkscreen.gbr, DisplayDriver-Edge_Cuts.gbr, DisplayDriver-F_Cu.gbr, DisplayDriver-F_Mask.gbr, DisplayDriver-F_Silkscreen.gbr, DisplayDriver-job.gbrjob]
2025-10-30 lap to PC
    [DisplayDriver.kicad_pcb, DisplayDriver.kicad_sch]
2025-10-30 change the ****** shifter footprint
    [DisplayDriver.kicad_pcb, DisplayDriver.kicad_sch]
2025-11-05 I swear this is the last PCB revision
    [DisplayDriver.kicad_pcb, DisplayDriver.kicad_sch]
2025-11-05 bill of mat.
    [DisplayDriver.kicad_pcb, DisplayDriver.kicad_sch, PCB Materials.csv]
2025-11-05 pcb review prep
    [DisplayDriver.kicad_pcb, DisplayDriver.kicad_sch]
2025-11-06 JLCPCB audit correction
    [DisplayDriver-B_Cu.gbr, DisplayDriver-B_Mask.gbr, DisplayDriver-B_Paste.gbr, DisplayDriver-B_Silkscreen.gbr, DisplayDriver-Edge_Cuts.gbr, DisplayDriver-F_Cu.gbr, DisplayDriver-F_Mask.gbr, DisplayDriver-F_Paste.gbr]
2025-11-06 audit additions (drill files)
    [DisplayDriver-B_Cu.gbl, DisplayDriver-B_Cu.gbr, DisplayDriver-B_Mask.gbs, DisplayDriver-B_Paste.gbp, DisplayDriver-B_Silkscreen.gbo, DisplayDriver-B_Silkscreen.gbr, DisplayDriver-Edge_Cuts.gbr, DisplayDriver-Edge_Cuts.gm1]
2025-12-07 DD3 (+josh stuff)
    [DisplayDriver.kicad_sch]
2025-12-07 Removed strong typing from adsb.py due to lack of support on CircuitPython, minor changes to code.py to change color of weather text based on temp
