zkeulr/aviator/documents/Design_Document/images/PCB/ModelPCB.jpg

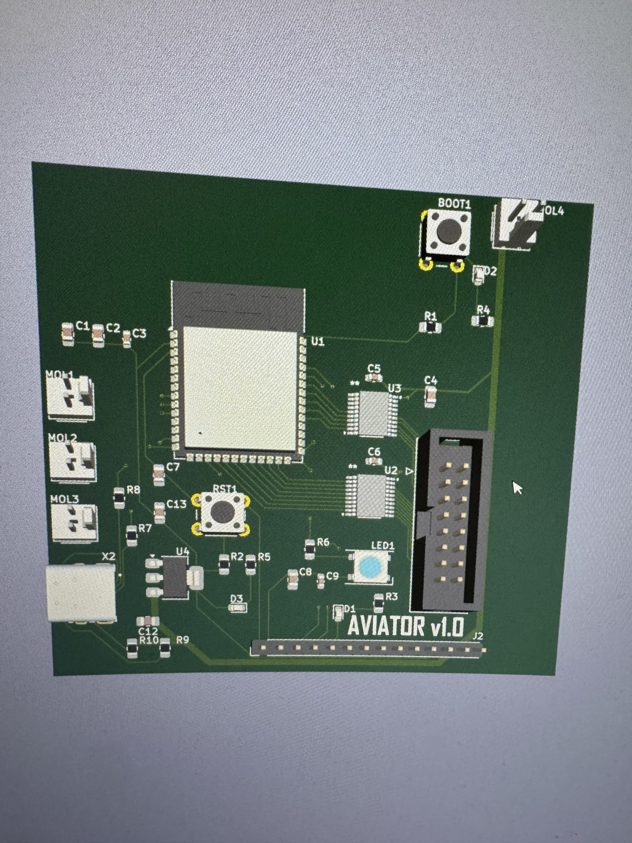
[picture p8: documents/Design_Document/images/PCB/ModelPCB.jpg]
documents/Design_Document/images/PCB/ModelPCB.jpg
